WouterPeletier/WouterKicadLibraries/README.md

# KicadLibraries
My KiCad6 Library files
