WouterPeletier/WouterKicadLibraries/3DModels/Capacitors/C_1206.step

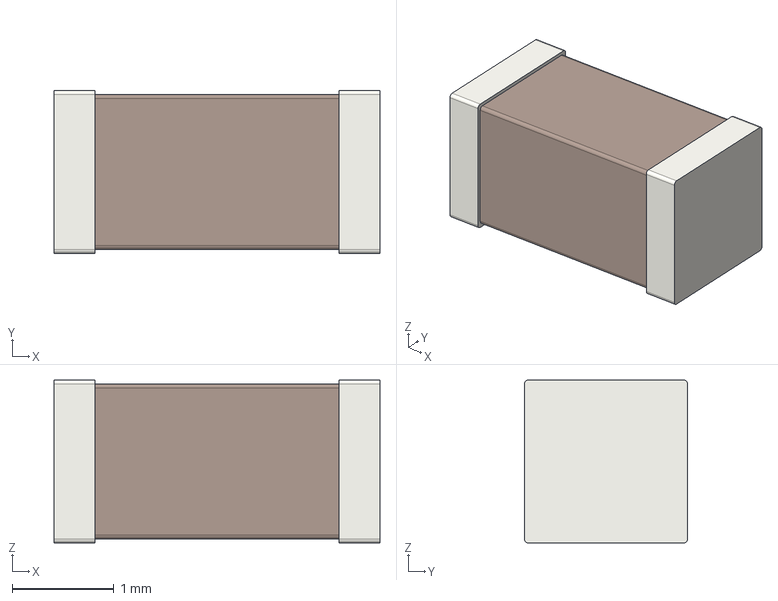
[picture p1: CAD file, 2023-02-23]
3DModels/Capacitors/C_1206.step
3.20 x 1.60 x 1.60 mm
