WouterPeletier/WouterKicadLibraries/3DModels/Connectors/TP1 Black.step

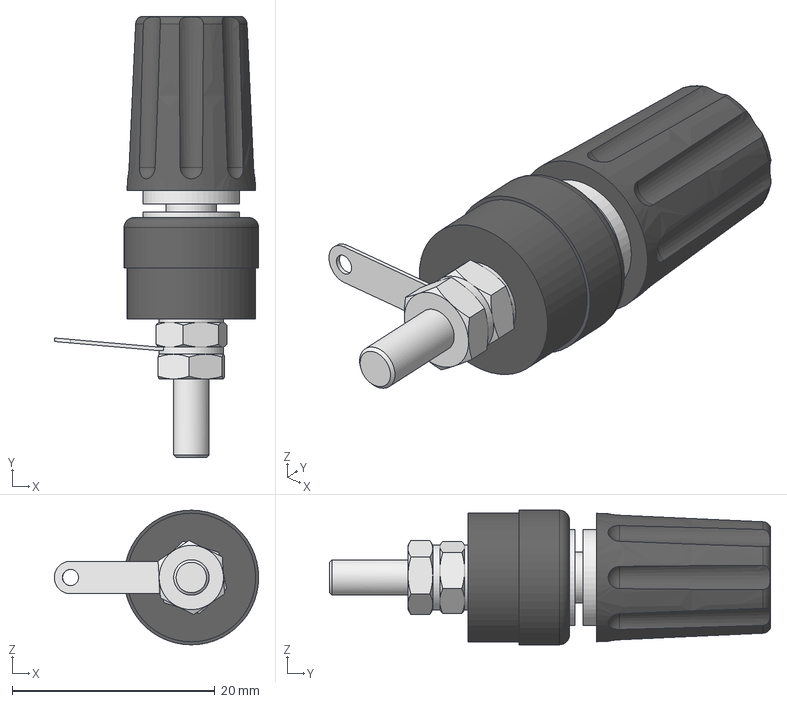
[picture p2: CAD file, 2023-02-23]
3DModels/Connectors/TP1 Black.step
20.2 x 43.5 x 13.3 mm
