WouterPeletier/WouterKicadLibraries/3DModels/Crystals/X_32x25.STEP

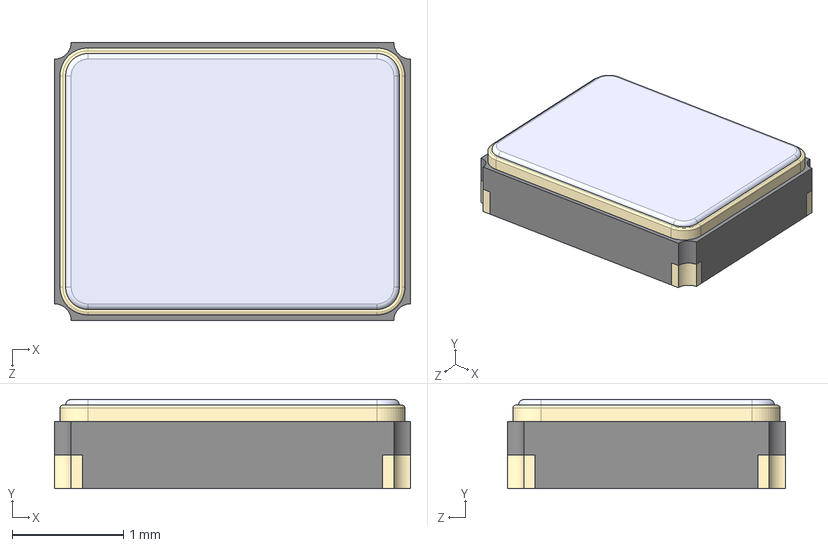
[picture p3: CAD file, 2023-02-23]
3DModels/Crystals/X_32x25.STEP
3.20 x 0.8 x 2.50 mm
