WouterPeletier/WouterKicadLibraries/3DModels/IntegratedCircuits/QFN28_5X5_SIL.step

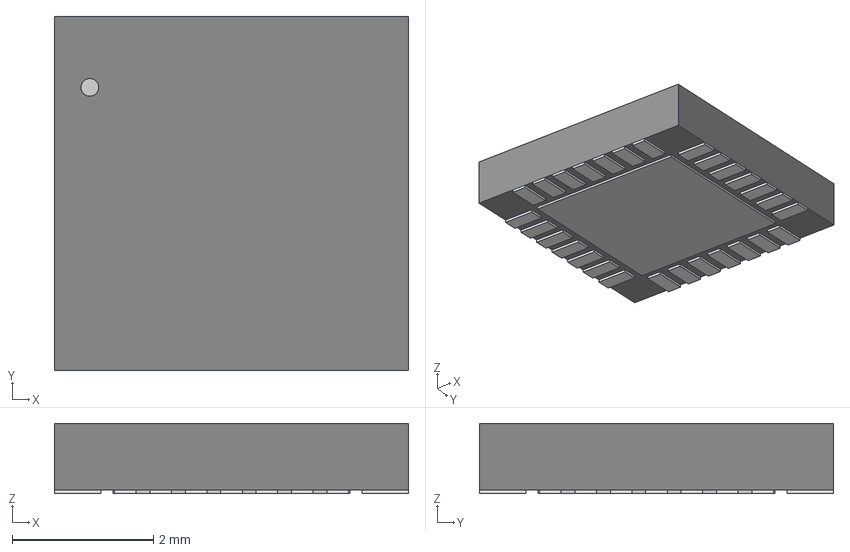
[picture p4: CAD file, 2023-02-23]
3DModels/IntegratedCircuits/QFN28_5X5_SIL.step
5.00 x 5.00 x 0.993 mm
