WouterPeletier/WouterKicadLibraries/3DModels/Mosfets/PQFN8 5X6, 1.27P.stp

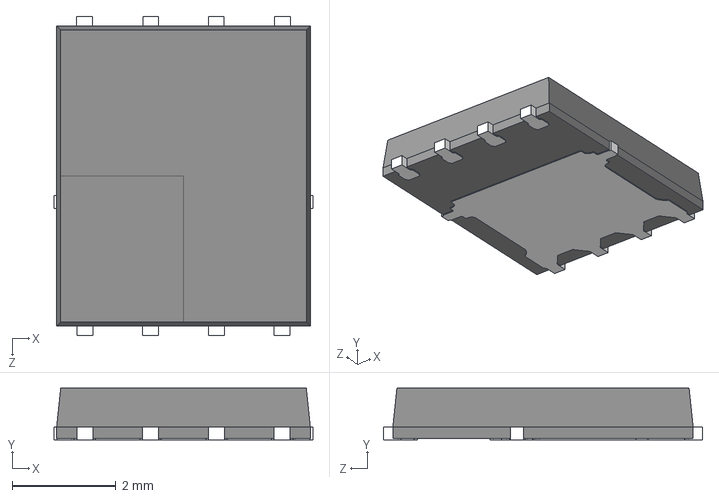
[picture p5: CAD file, 2023-02-23]
3DModels/Mosfets/PQFN8 5X6, 1.27P.stp
5.00 x 1.00 x 6.16 mm
