WouterPeletier/WouterKicadLibraries/3DModels/MSOP-12_MSE_LIT.step

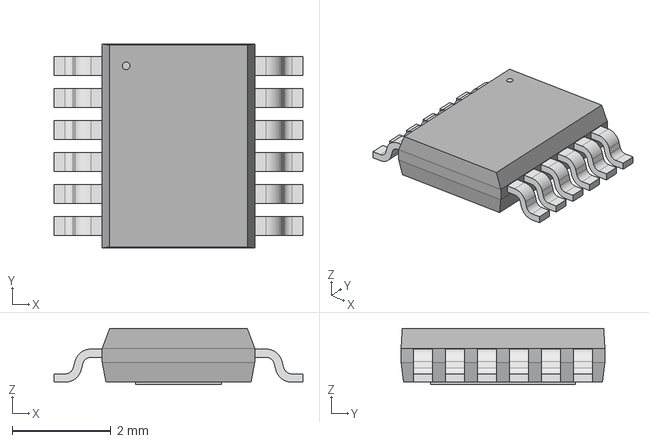
[picture p6: CAD file, 2023-02-23]
3DModels/MSOP-12_MSE_LIT.step
5.05 x 4.14 x 1.15 mm
