WouterPeletier/WouterKicadLibraries/3DModels/Resistors/R_0603.step

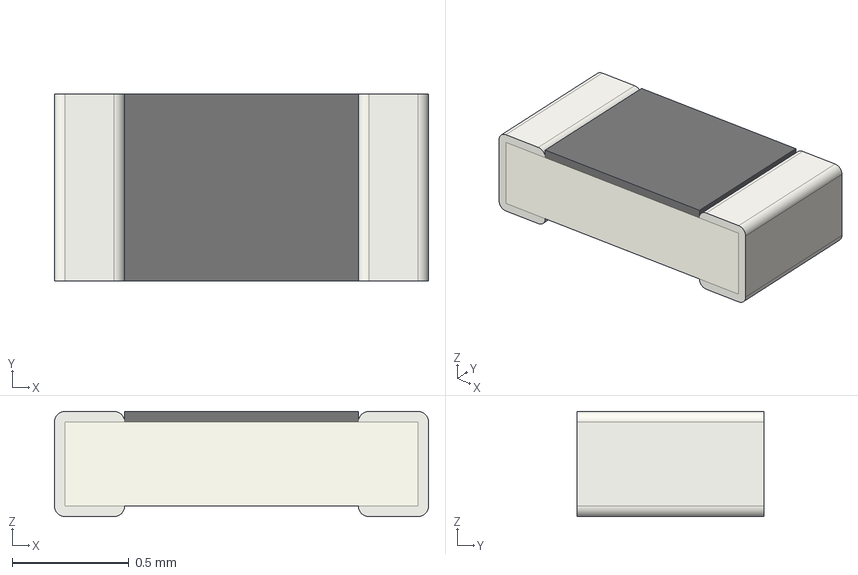
[picture p7: CAD file, 2023-02-23]
3DModels/Resistors/R_0603.step
1.60 x 0.8 x 0.45 mm
