WouterPeletier/WouterKicadLibraries/3DModels/Capacitors/C_2512.step

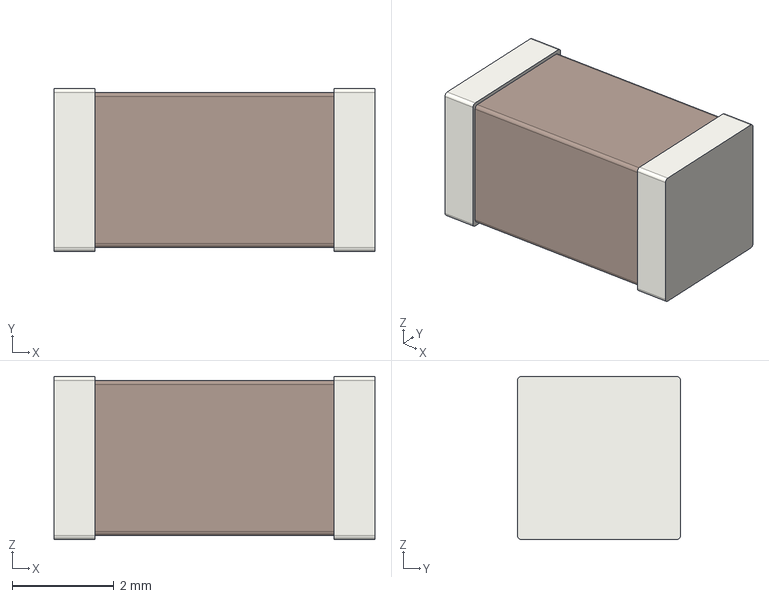
[picture p8: CAD file, 2023-02-23]
3DModels/Capacitors/C_2512.step
6.30 x 3.20 x 3.20 mm
