WouterPeletier/WouterKicadLibraries/3DModels/IntegratedCircuits/CP2102N-A02-GQFN20R.stp

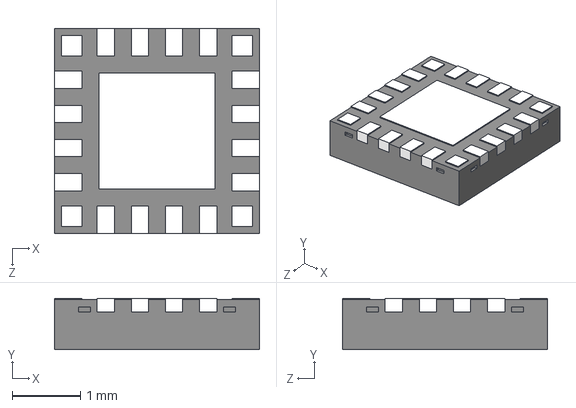
[picture p9: CAD file, 2023-02-23]
3DModels/IntegratedCircuits/CP2102N-A02-GQFN20R.stp
3.00 x 0.75 x 3.00 mm
