WouterPeletier/WouterKicadLibraries/3DModels/Q5B.stp

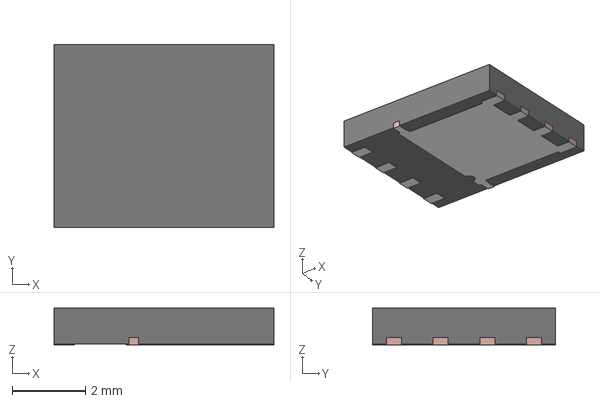
[picture p10: CAD file, 2023-02-23]
3DModels/Q5B.stp
6.00 x 5.00 x 1.00 mm
FRAME
MOLD
