WouterPeletier/WouterKicadLibraries/3DModels/Resistors/R_2512.step

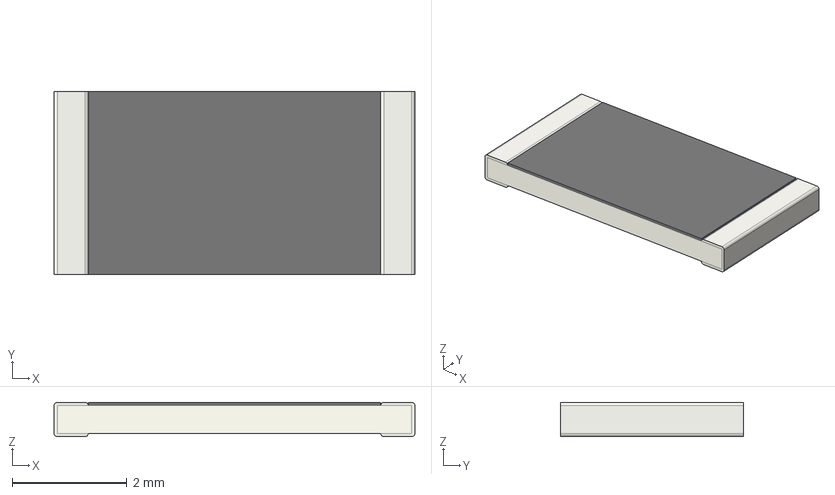
[picture p11: CAD file, 2023-02-23]
3DModels/Resistors/R_2512.step
6.30 x 3.20 x 0.6 mm
