WouterPeletier/WouterKicadLibraries/3DModels/Capacitors/C_2220.step

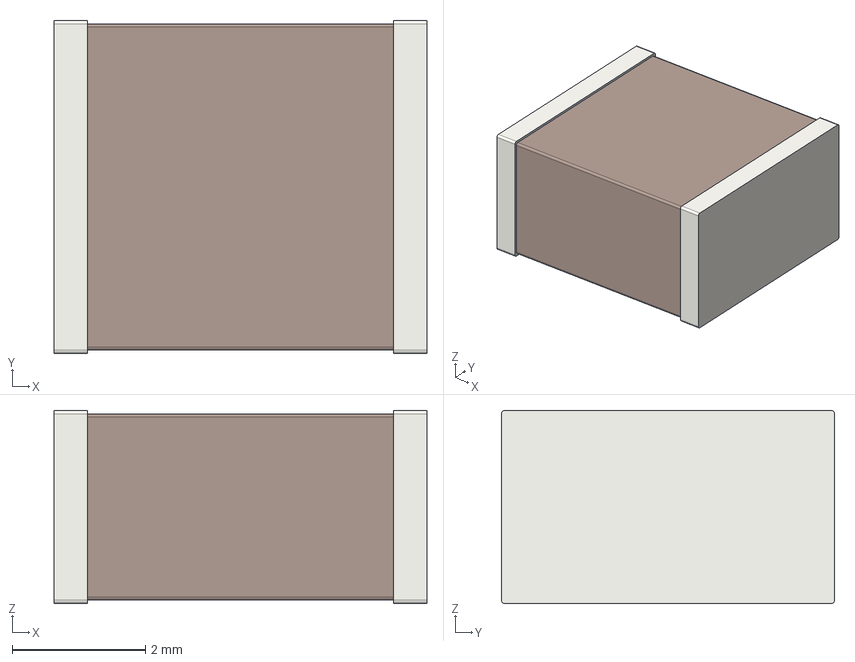
[picture p12: CAD file, 2023-02-23]
3DModels/Capacitors/C_2220.step
5.60 x 5.00 x 2.90 mm
