WouterPeletier/WouterKicadLibraries/3DModels/Connectors/JST-SM04B-GHS-TB_LF__SN_.stp

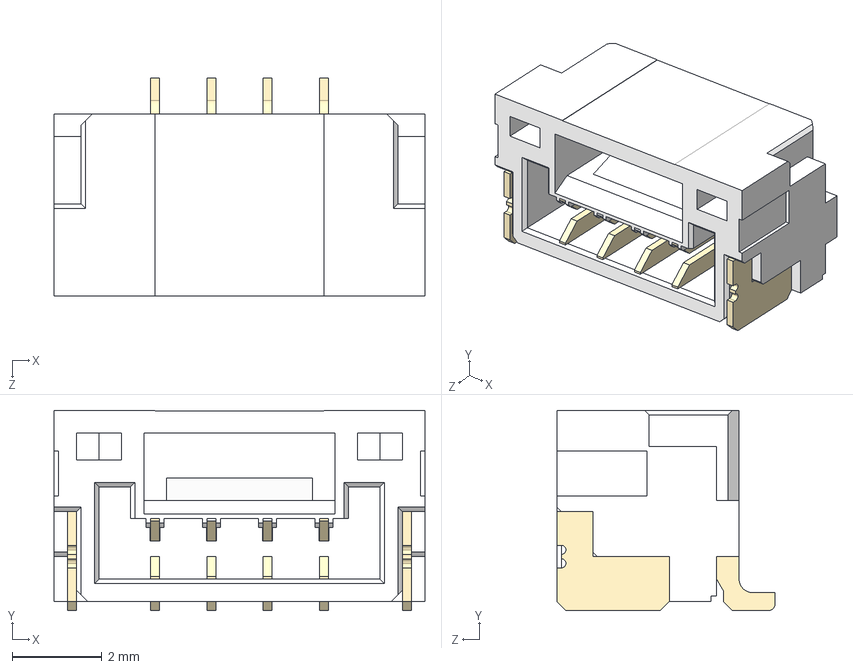
[picture p13: CAD file, 2023-02-23]
3DModels/Connectors/JST-SM04B-GHS-TB_LF__SN_.stp
8.25 x 4.45 x 4.85 mm
