WouterPeletier/WouterKicadLibraries/3DModels/IntegratedCircuits/MSOP-10-EP.step

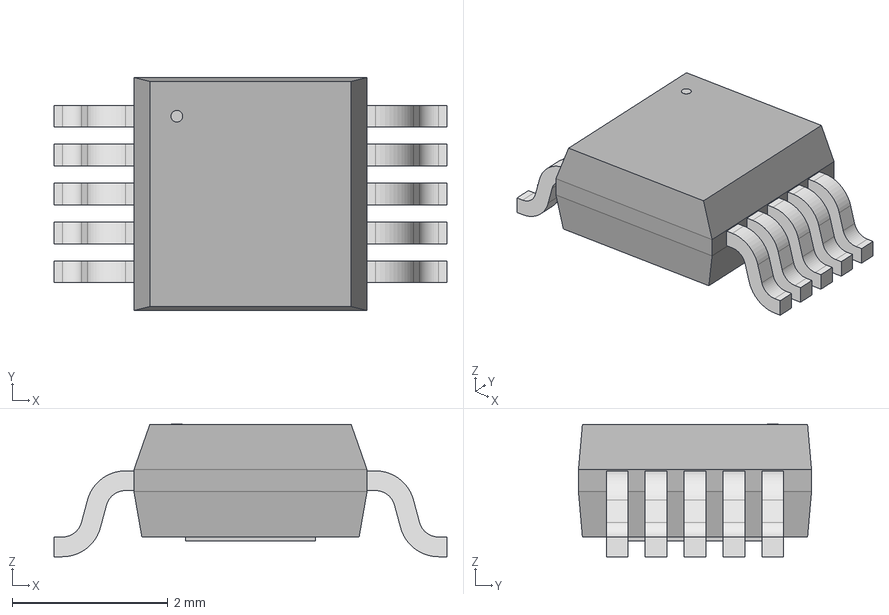
[picture p14: CAD file, 2023-02-23]
3DModels/IntegratedCircuits/MSOP-10-EP.step
5.05 x 3.00 x 1.70 mm
