WouterPeletier/WouterKicadLibraries/3DModels/Resistors/R_0805.step

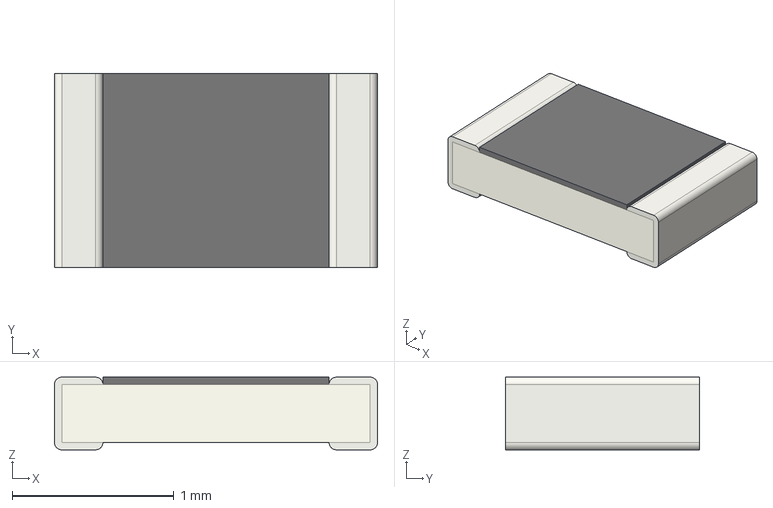
[picture p15: CAD file, 2023-02-23]
3DModels/Resistors/R_0805.step
2.00 x 1.20 x 0.45 mm
