WouterPeletier/WouterKicadLibraries/3DModels/SOT-23-6.step

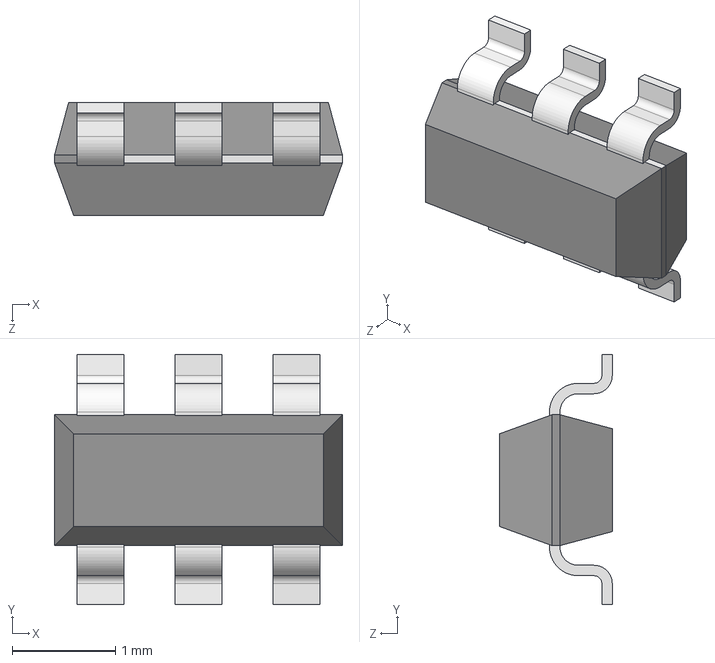
[picture p16: CAD file, 2023-02-23]
3DModels/SOT-23-6.step
2.79 x 2.43 x 1.09 mm
