WouterPeletier/WouterKicadLibraries/3DModels/Capacitors/C_0402.step

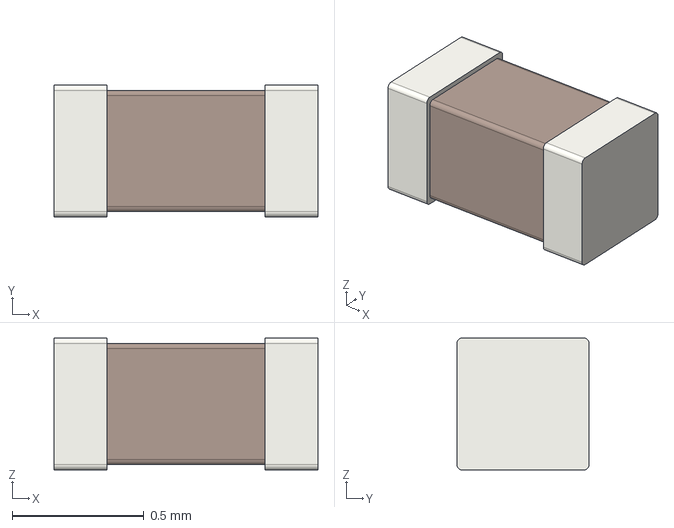
[picture p17: CAD file, 2023-02-23]
3DModels/Capacitors/C_0402.step
1.00 x 0.5 x 0.5 mm
