WouterPeletier/WouterKicadLibraries/3DModels/PowerFLAT5x6.stp

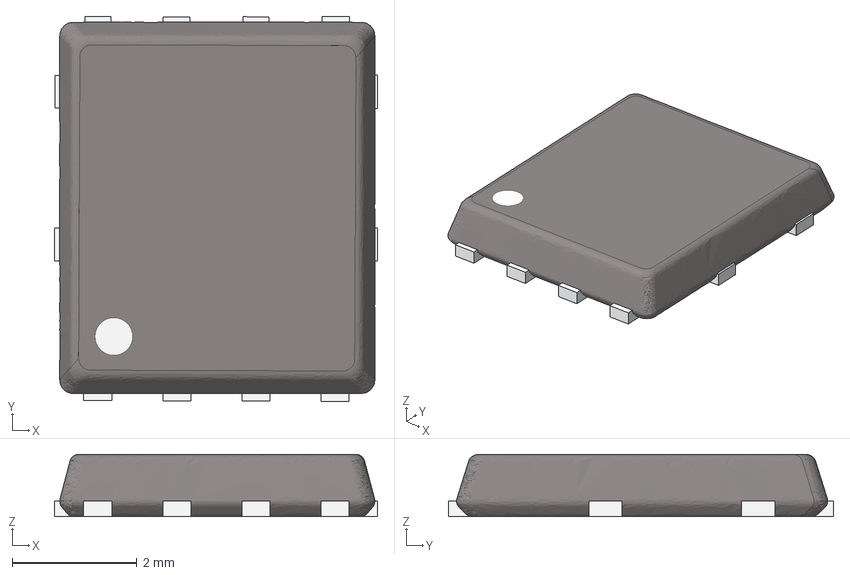
[picture p18: CAD file, 2023-02-23]
3DModels/PowerFLAT5x6.stp
5.19 x 6.18 x 1.00 mm
