WouterPeletier/WouterKicadLibraries/3DModels/Resistors/R_1210.step

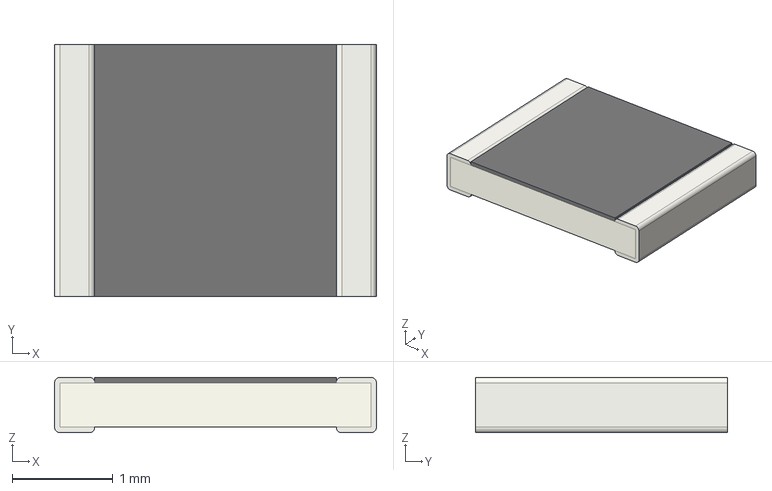
[picture p19: CAD file, 2023-02-23]
3DModels/Resistors/R_1210.step
3.20 x 2.50 x 0.55 mm
