WouterPeletier/WouterKicadLibraries/3DModels/Capacitors/C_2225.step

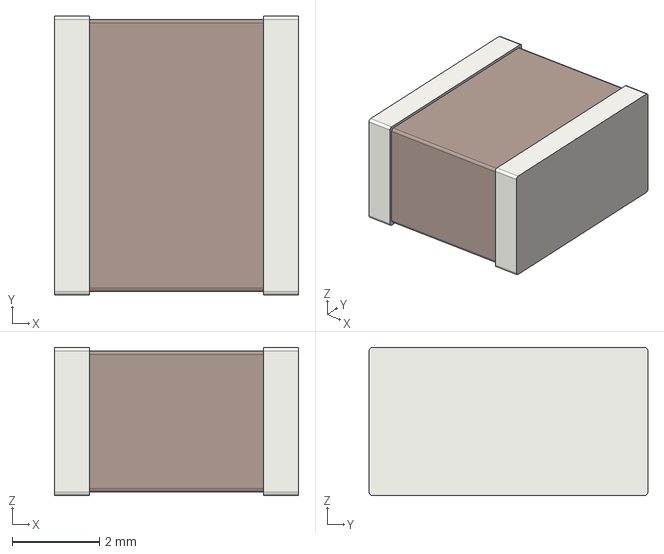
[picture p20: CAD file, 2023-02-23]
3DModels/Capacitors/C_2225.step
5.60 x 6.40 x 3.40 mm
