WouterPeletier/WouterKicadLibraries/3DModels/MINISO8_STM.step

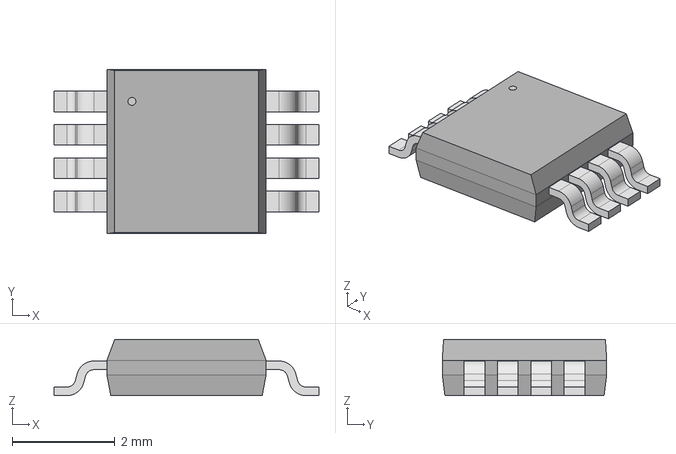
[picture p21: CAD file, 2023-02-23]
3DModels/MINISO8_STM.step
5.16 x 3.20 x 1.09 mm
