WouterPeletier/WouterKicadLibraries/3DModels/Resistors/R_1206.step

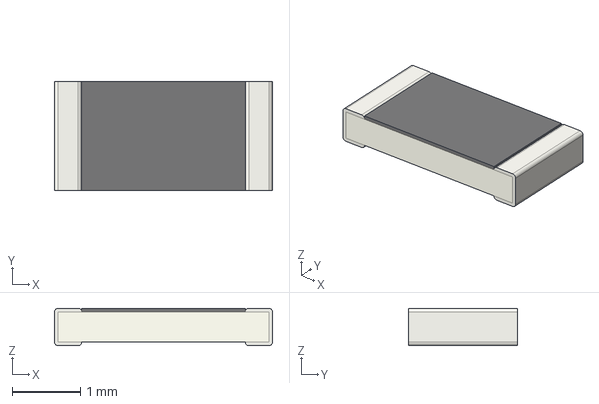
[picture p22: CAD file, 2023-02-23]
3DModels/Resistors/R_1206.step
3.20 x 1.60 x 0.55 mm
