WouterPeletier/WouterKicadLibraries/3DModels/2x5.08mmTerminalBlock.stp

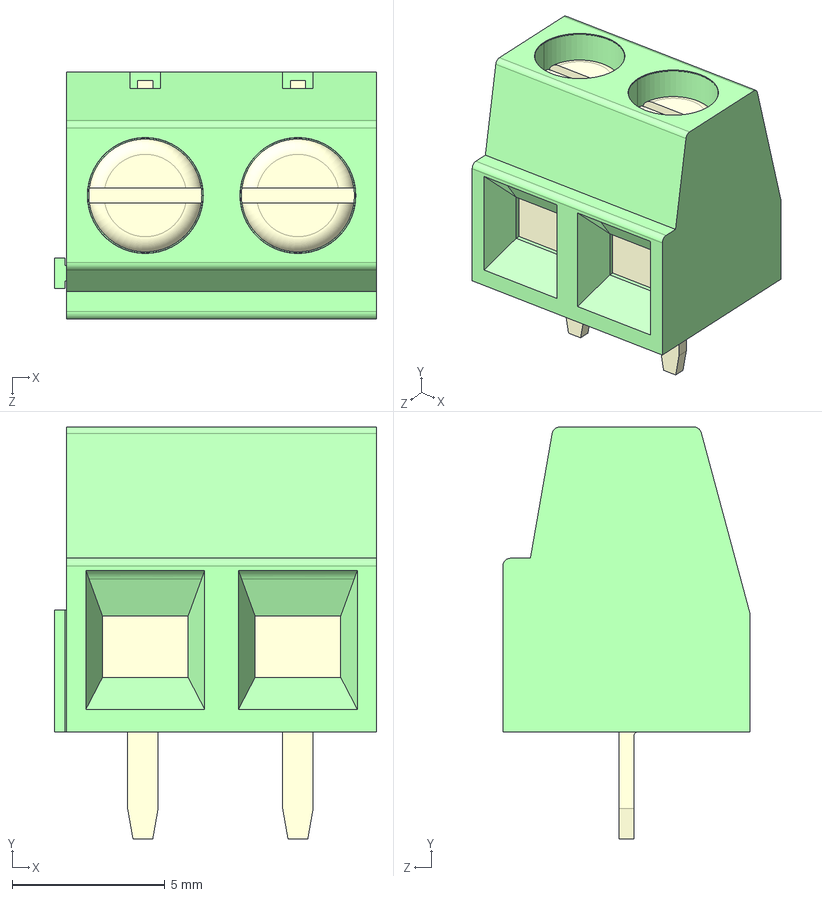
[picture p23: CAD file, 2023-02-23]
3DModels/2x5.08mmTerminalBlock.stp
10.6 x 13.5 x 8.10 mm
