WouterPeletier/WouterKicadLibraries/3DModels/Capacitors/C_2010.step

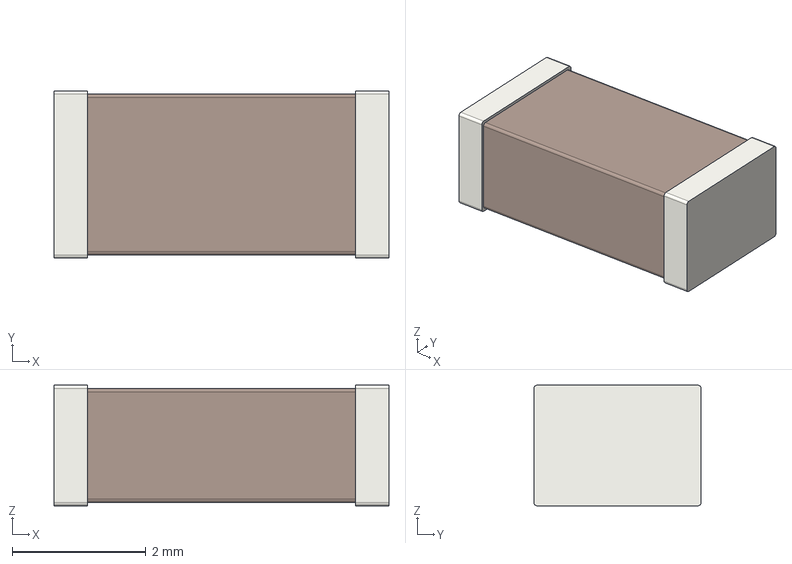
[picture p24: CAD file, 2023-02-23]
3DModels/Capacitors/C_2010.step
5.00 x 2.50 x 1.80 mm
