WouterPeletier/WouterKicadLibraries/3DModels/Resistors/R_0402.step

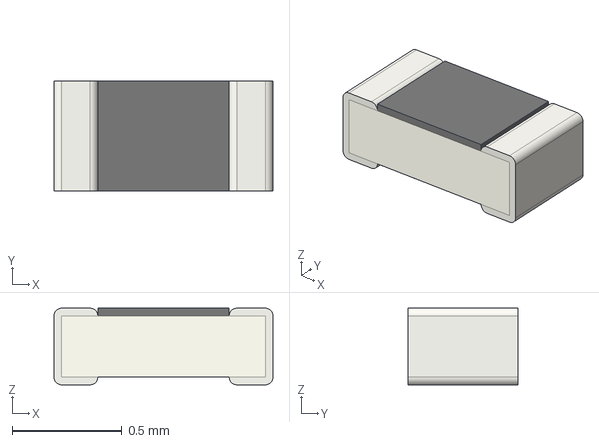
[picture p25: CAD file, 2023-02-23]
3DModels/Resistors/R_0402.step
1.00 x 0.5 x 0.35 mm
