WouterPeletier/WouterKicadLibraries/3DModels/48LQFP.step

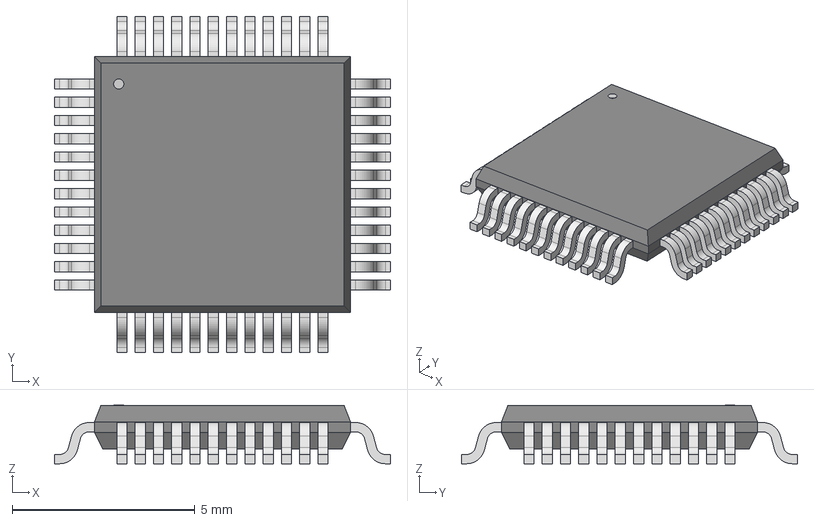
[picture p26: CAD file, 2023-02-23]
3DModels/48LQFP.step
9.19 x 9.19 x 1.60 mm
