WouterPeletier/WouterKicadLibraries/3DModels/Capacitors/C_0805.step

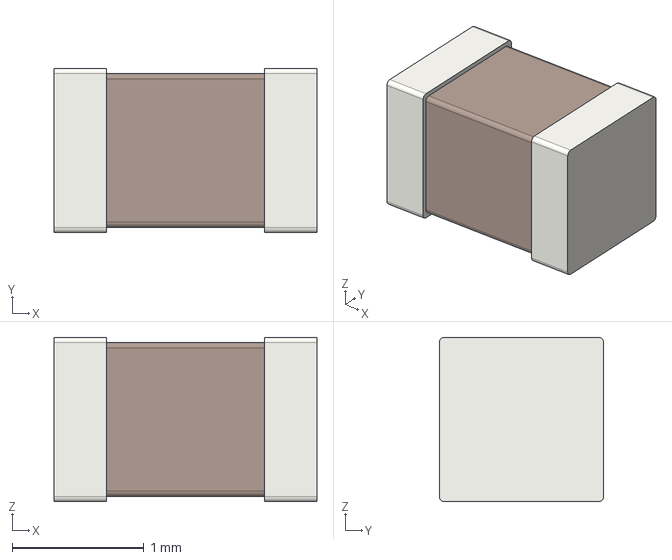
[picture p27: CAD file, 2023-02-23]
3DModels/Capacitors/C_0805.step
2.00 x 1.25 x 1.25 mm
