WouterPeletier/WouterKicadLibraries/3DModels/Resistors/R_1812.step

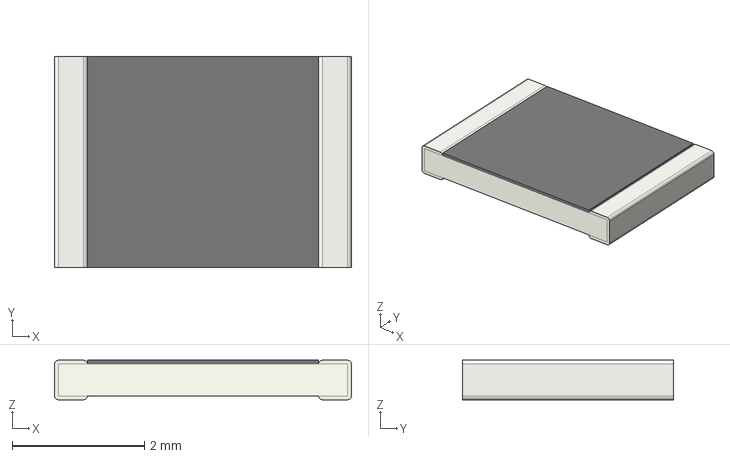
[picture p28: CAD file, 2023-02-23]
3DModels/Resistors/R_1812.step
4.50 x 3.20 x 0.6 mm
