WouterPeletier/WouterKicadLibraries/3DModels/Capacitors/C_1806.step

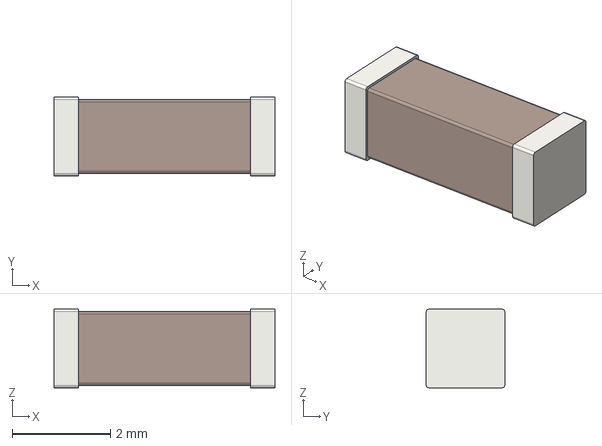
[picture p29: CAD file, 2023-02-23]
3DModels/Capacitors/C_1806.step
4.50 x 1.60 x 1.60 mm
