WouterPeletier/WouterKicadLibraries/3DModels/SOIC127P600X175-14N.stp

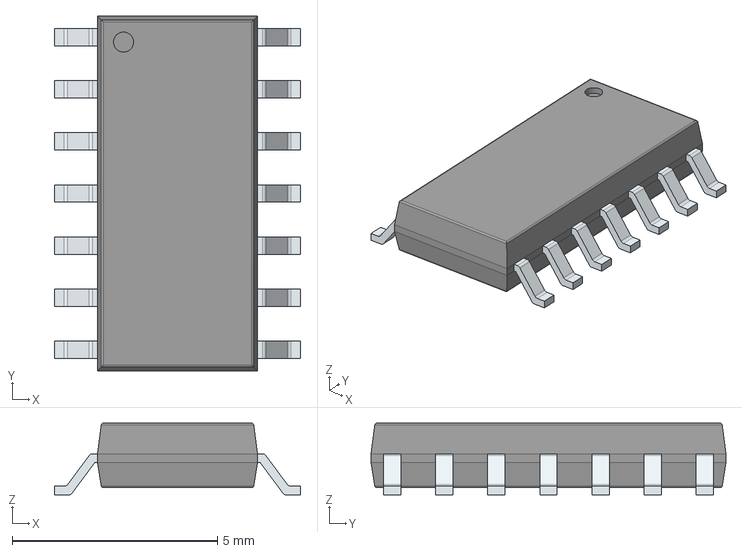
[picture p30: CAD file, 2023-02-23]
3DModels/SOIC127P600X175-14N.stp
6.00 x 8.65 x 1.75 mm
PinsArrayLR
