WouterPeletier/WouterKicadLibraries/3DModels/Capacitors/C_1812.step

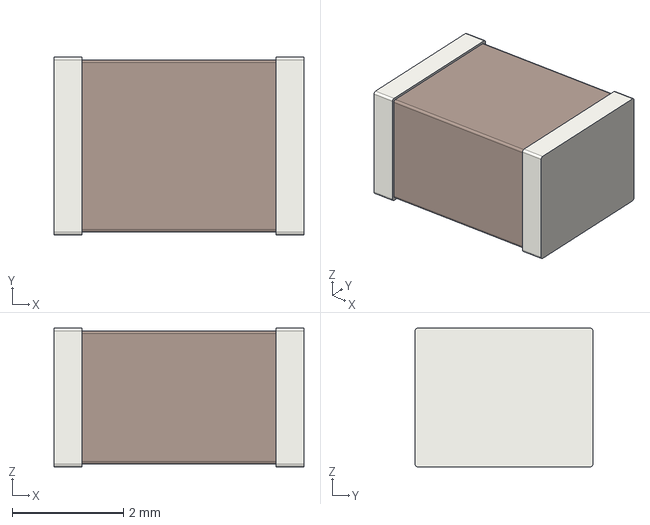
[picture p31: CAD file, 2023-02-23]
3DModels/Capacitors/C_1812.step
4.50 x 3.20 x 2.50 mm
