WouterPeletier/WouterKicadLibraries/3DModels/SOD-123FL.step

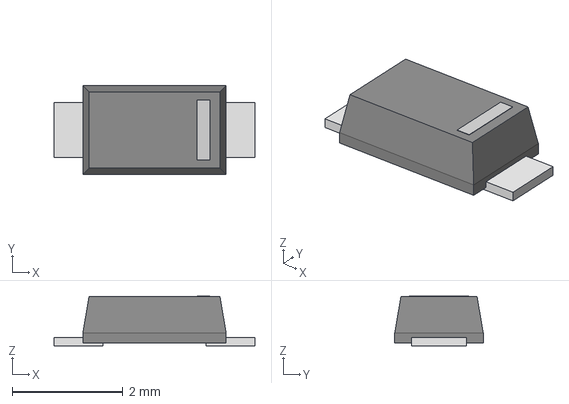
[picture p32: CAD file, 2023-02-23]
3DModels/SOD-123FL.step
3.63 x 1.60 x 0.895 mm
