WouterPeletier/WouterKicadLibraries/3DModels/Capacitors/C_1210.step

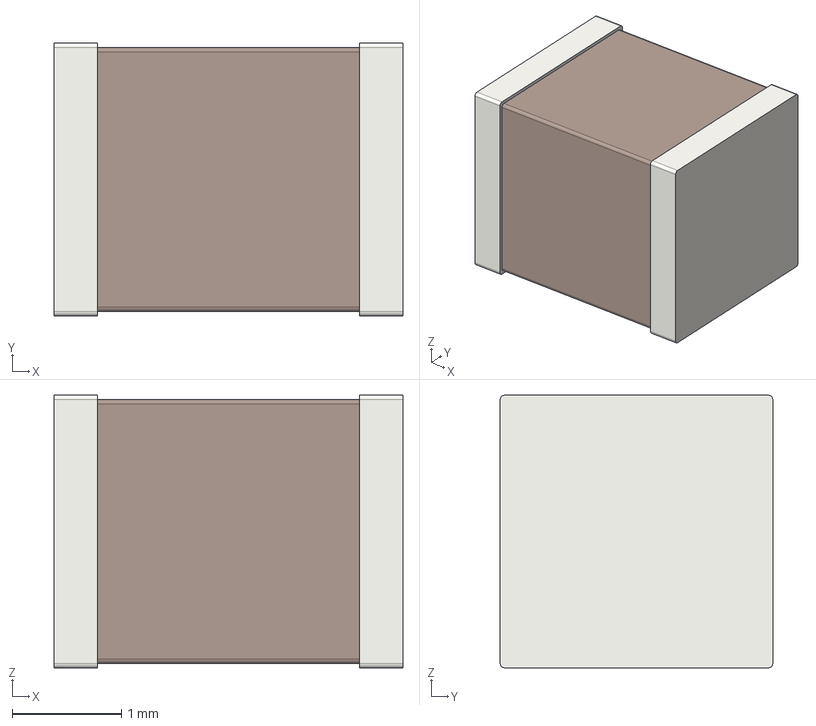
[picture p33: CAD file, 2023-02-23]
3DModels/Capacitors/C_1210.step
3.20 x 2.50 x 2.50 mm
