WouterPeletier/WouterKicadLibraries/3DModels/VSSOP-10.stp

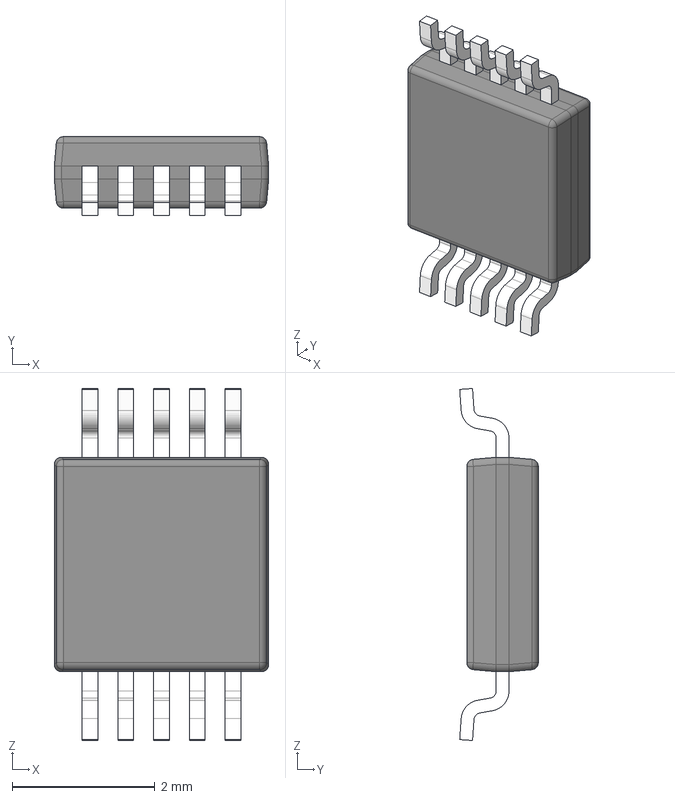
[picture p34: CAD file, 2023-02-23]
3DModels/VSSOP-10.stp
3.00 x 1.10 x 4.93 mm
BODY-SO
LEAD-SO x 10
PIN1-ID
