WouterPeletier/WouterKicadLibraries/3DModels/Capacitors/C_0603.step

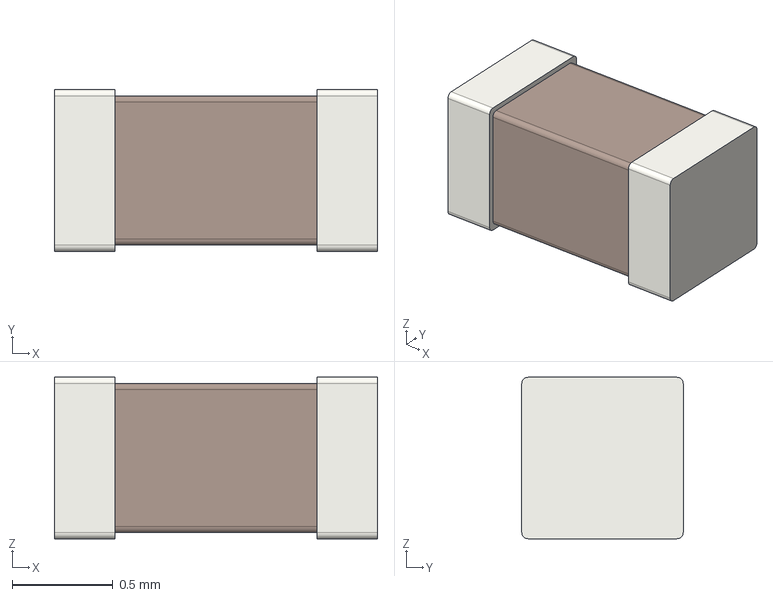
[picture p35: CAD file, 2023-02-23]
3DModels/Capacitors/C_0603.step
1.60 x 0.8 x 0.8 mm
