WouterPeletier/WouterKicadLibraries/3DModels/SOT-23-5.step

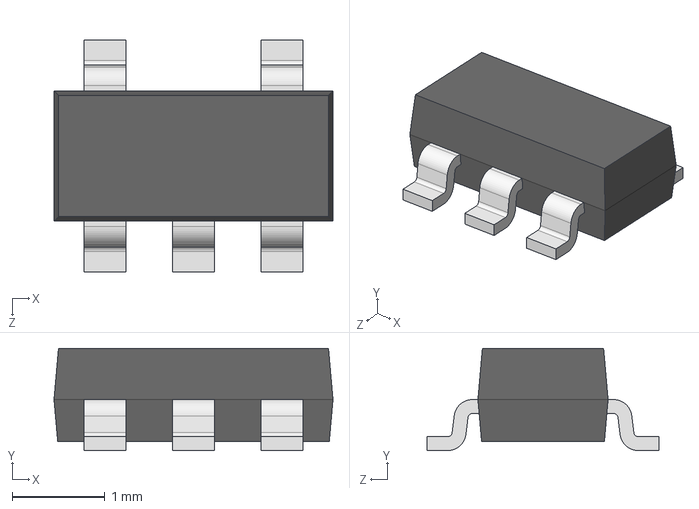
[picture p36: CAD file, 2023-02-23]
3DModels/SOT-23-5.step
3.00 x 1.10 x 2.50 mm
