WouterPeletier/WouterKicadLibraries/3DModels/SOT-23-3.step

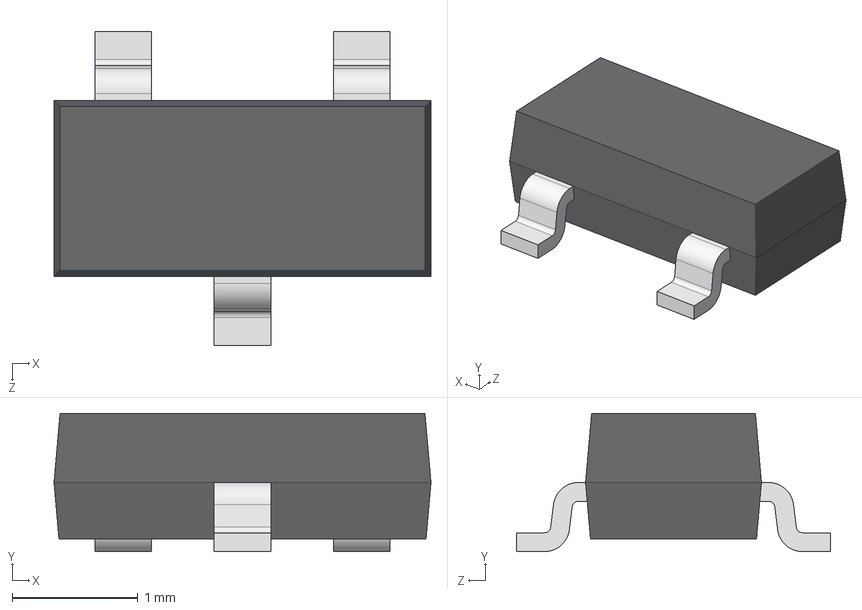
[picture p37: CAD file, 2023-02-23]
3DModels/SOT-23-3.step
3.00 x 1.10 x 2.50 mm
