WouterPeletier/WouterKicadLibraries/3DModels/R_2512-FZ-R001E-2.stp

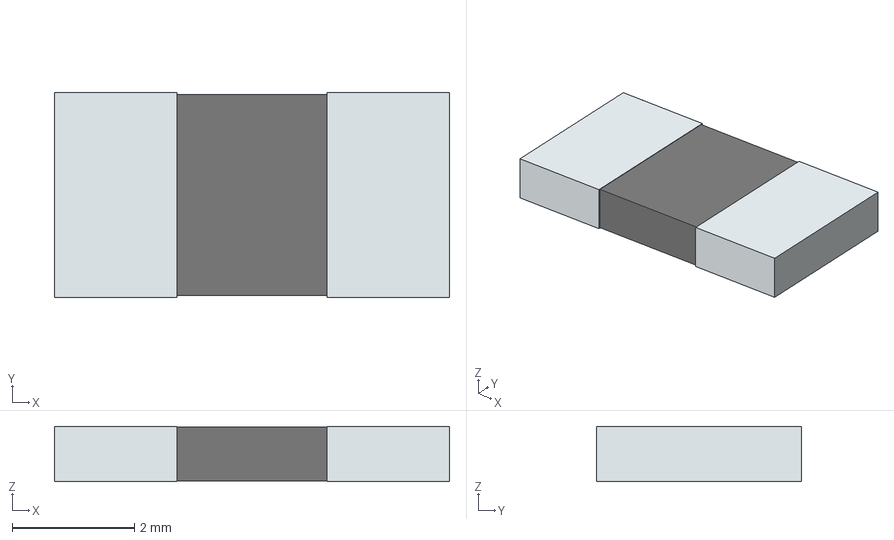
[picture p38: CAD file, 2023-02-23]
3DModels/R_2512-FZ-R001E-2.stp
6.45 x 3.35 x 0.9 mm
term1
term2
