WouterPeletier/WouterKicadLibraries/3DModels/F_1206.step

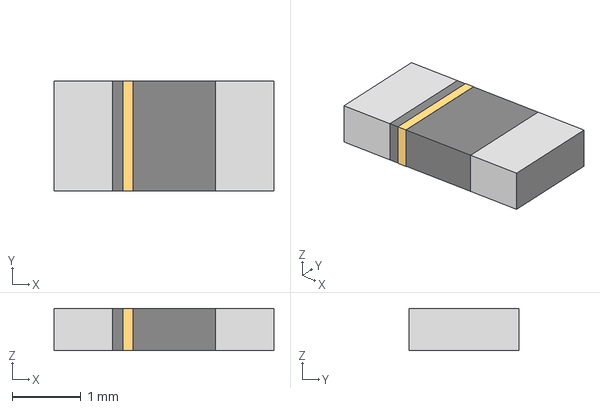
[picture p39: CAD file, 2023-02-23]
3DModels/F_1206.step
3.20 x 1.61 x 0.615 mm
