WouterPeletier/WouterKicadLibraries/3DModels/Ethernet-J1B1211CCD.step

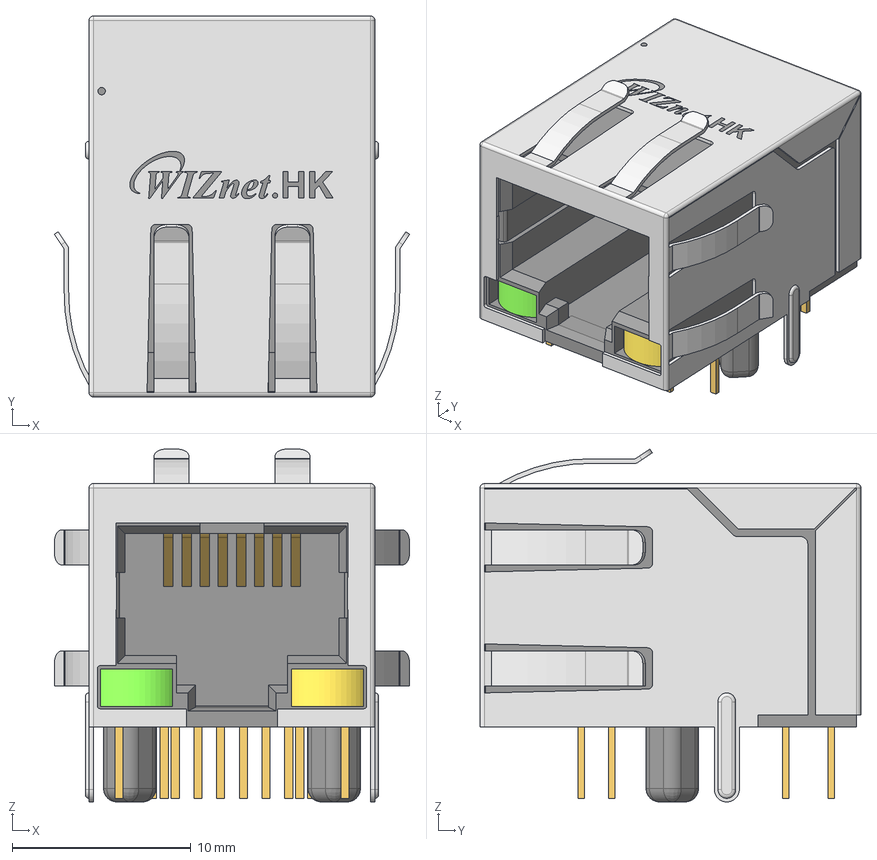
[picture p40: CAD file, 2023-02-23]
3DModels/Ethernet-J1B1211CCD.step
19.9 x 21.3 x 19.7 mm
logo
terminal
yellow led
green led
