WouterPeletier/WouterKicadLibraries/3DModels/PG-SOT363.stp

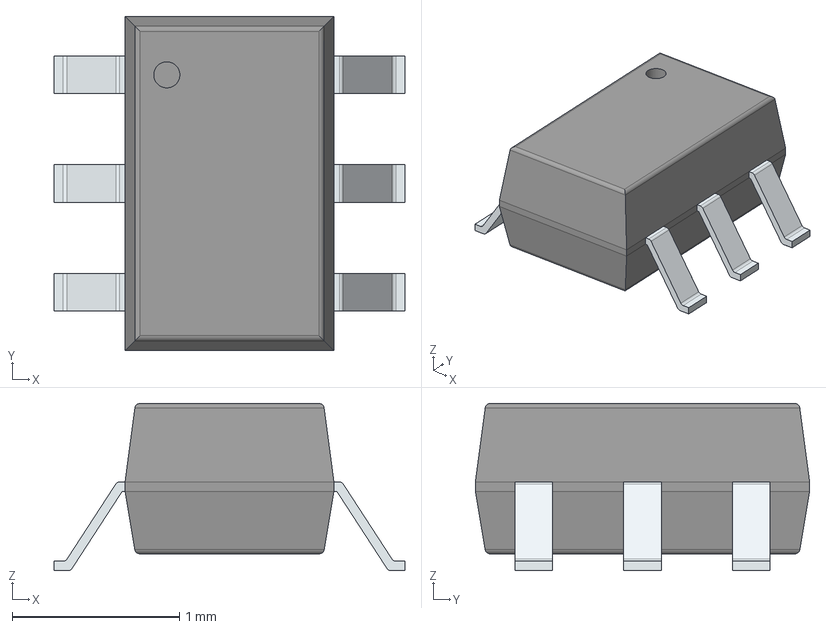
[picture p41: CAD file, 2023-02-23]
3DModels/PG-SOT363.stp
2.10 x 2.00 x 1.00 mm
PinsArrayLR
