WouterPeletier/WouterKicadLibraries/3DModels/LQH32CN100K33L.stp

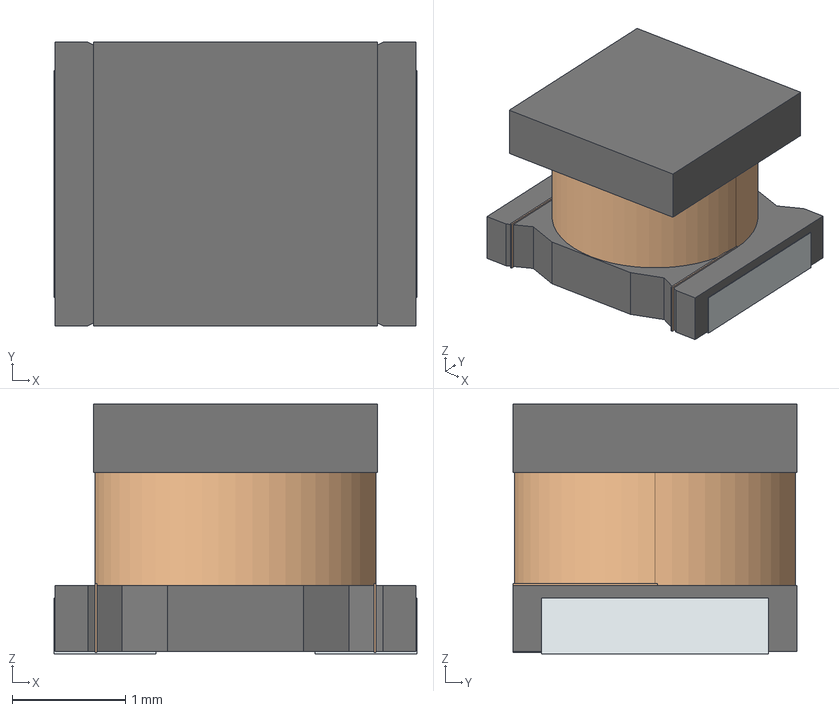
[picture p42: CAD file, 2023-02-23]
3DModels/LQH32CN100K33L.stp
3.20 x 2.50 x 2.20 mm
Rect1
Rect2
Rect3
Rect4
Rect5
