WouterPeletier/WouterKicadLibraries/3DModels/SOT_223.step

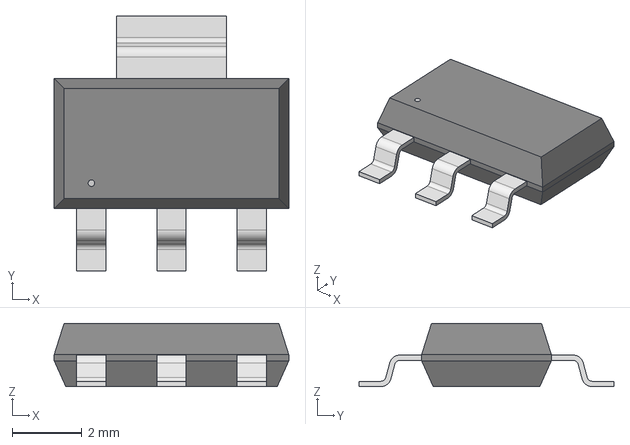
[picture p43: CAD file, 2023-02-23]
3DModels/SOT_223.step
6.71 x 7.29 x 1.81 mm
