WouterPeletier/WouterKicadLibraries/3DModels/LED_0603.stp

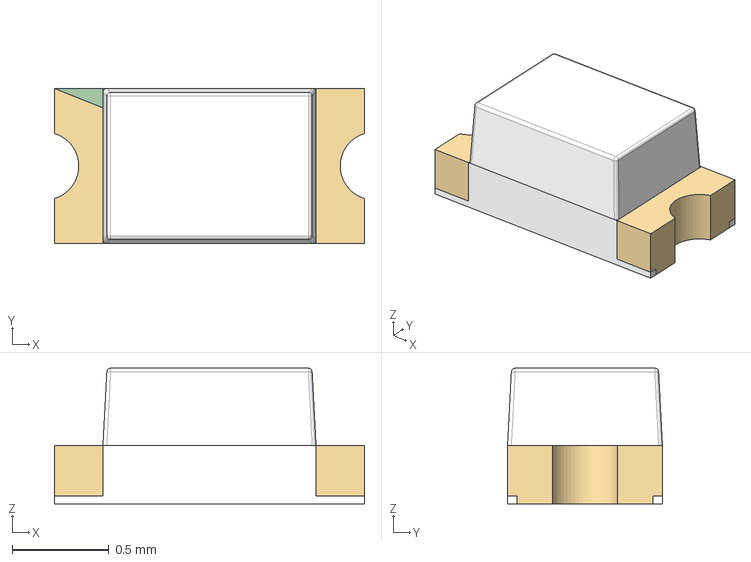
[picture p44: CAD file, 2023-02-23]
3DModels/LED_0603.stp
1.60 x 0.8 x 0.7 mm
