WouterPeletier/WouterKicadLibraries/3DModels/FB_0402.stp

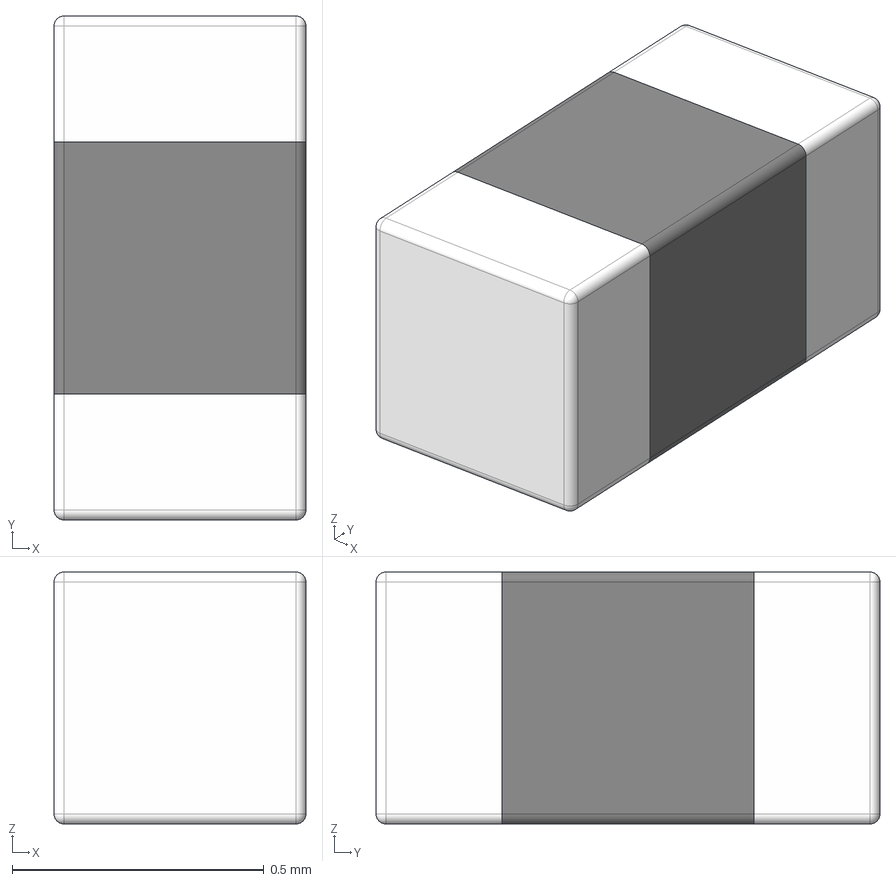
[picture p45: CAD file, 2023-02-23]
3DModels/FB_0402.stp
0.5 x 1.00 x 0.5 mm
