WouterPeletier/WouterKicadLibraries/3DModels/DC3-2.54-10.stp

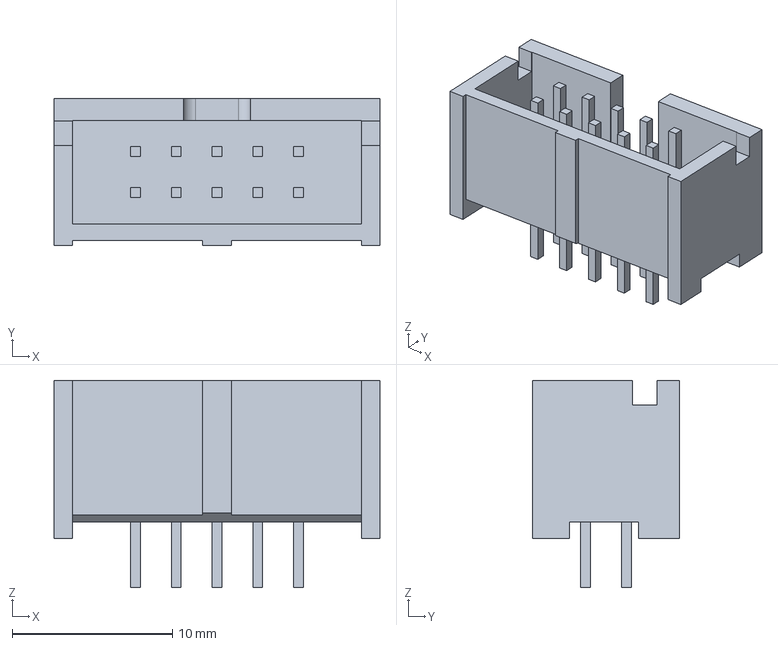
[picture p46: CAD file, 2023-02-23]
3DModels/DC3-2.54-10.stp
20.3 x 9.14 x 12.9 mm
