WouterPeletier/WouterKicadLibraries/3DModels/SMCJ58A.stp

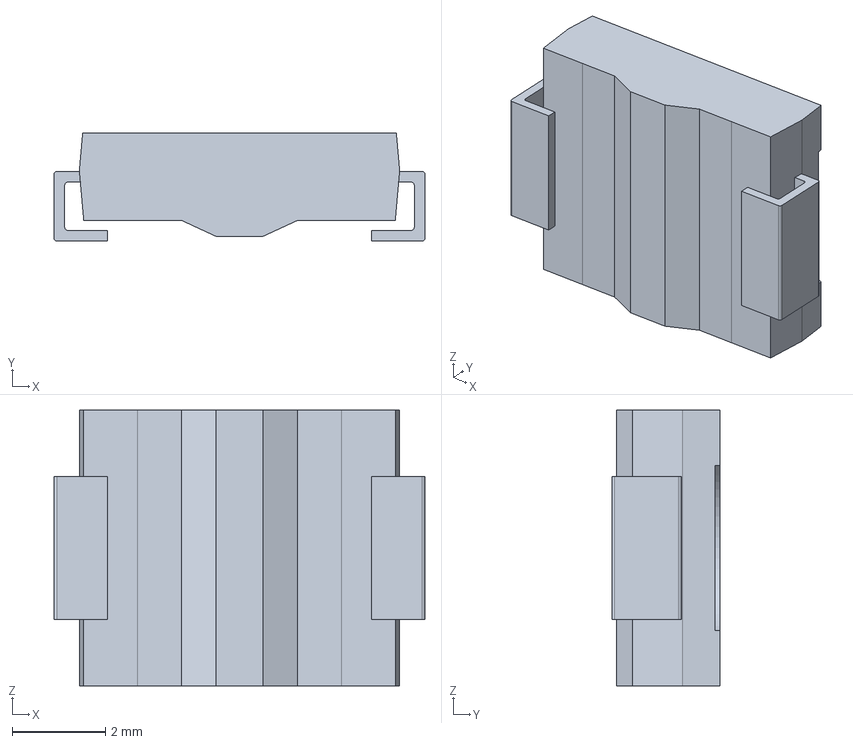
[picture p47: CAD file, 2023-02-23]
3DModels/SMCJ58A.stp
7.94 x 2.31 x 5.91 mm
