WouterPeletier/WouterKicadLibraries/(list of files, cad)

Other CAD files:
3DModels/Connectors/TP1 Red.step
3DModels/Connectors/TP1 Yellow.step
3DModels/Connectors/TP1 White.step
3DModels/Connectors/TP1 Green.step
3DModels/Connectors/TP1 Blue.step
3DModels/SOIC-14_3.9x8.7mm_P1.27mm.step
