WouterPeletier/WouterKicadLibraries/(commit log)

2022-10-12 Finished SMCJ5BA footprint and symbol
2022-10-27 Added Terminal block, Jumpers, a mosfet, two bridge rectifier controllers, and a diode.
2022-10-27 Added Terminal block, jumpers, a mosfet, two bridge rectifier controllers and a diode, but this time i staged them (I hope)
    [2x5.08mmTerminalBlock.stp, MSOP-12_MSE_LIT.step, PowerFLAT5x6.stp, Q5B.stp, SOIC127P600X175-14N.stp]
2022-10-28 Added a lot of 3d files for caps and resistors, also added some new chips
    [C_0402.step, C_0603.step, C_0805.step, C_1206.step, C_1210.step, C_1806.step, C_1812.step, C_2010.step]
2022-10-28 Updated 2N7002 schematic symbol
2022-11-03 Added A lot of things, I promise this should get better haha
    [48LQFP.step, ABM8-25.000MHZ-D2Y-T.stp, DC3-2.54-10.stp, Ethernet-J1B1211CCD.step, LQH32CN100K33L.stp, SOT-23-3.step, SOT-23-5.step, SOT-23-6.step]
2022-11-08 Added TP1 connectors in W_Connectors
    [TP1 Black.step, TP1 Blue.step, TP1 Green.step, TP1 Red.step, TP1 White.step, TP1 Yellow.step]
2022-11-08 Edited Courtyards of TP1 connectors, LT4320IMSE-TRPBF and JUMP1.5x2.0
2022-11-15 Cleaned up the cryststals, added a 4 pin jst gh connector
    [ABM8-25.000MHZ-D2Y-T.stp]
2022-11-15 don't know what happened
    [JST-SM04B-GHS-TB_LF__SN_.stp, X_32x25.STEP]
2022-11-28 Updated many incorrect footprints and added some logic gates
2023-02-23 Updated lots
    [2x5.08mmTerminalBlock.stp, 48LQFP.step, CP2102N-A02-GQFN20R.stp, C_0402.step, C_0603.step, C_0805.step, C_1206.step, C_1210.step]
